fwillard/CANTranslate/Hardware/KiCad/CANTranslate/KMR223G LFG.STEP

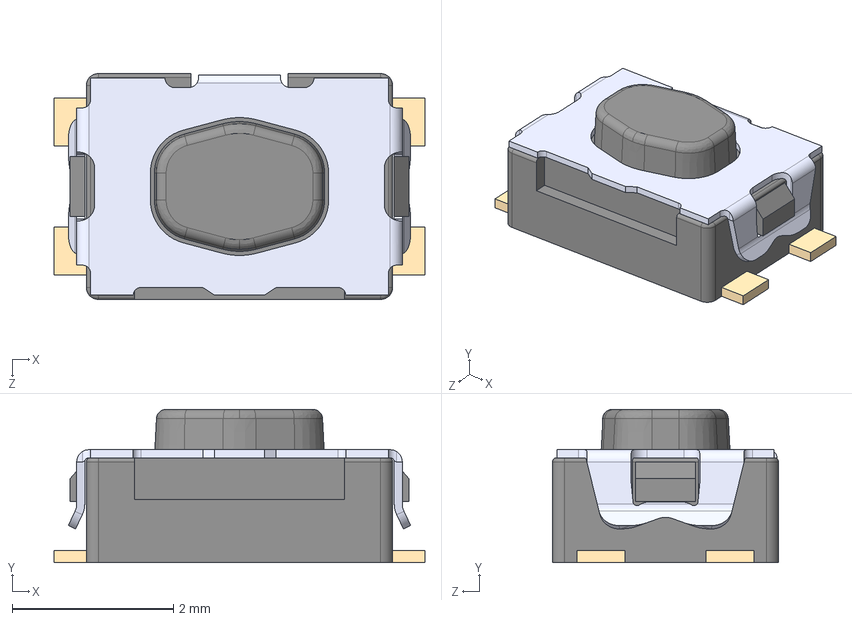
[picture p2: CAD file, 2025-05-18]
Hardware/KiCad/CANTranslate/KMR223G LFG.STEP
4.60 x 1.90 x 2.80 mm
