fwillard/CANTranslate/Hardware/KiCad/CANTranslate/Schematic/CANTranslate.pdf

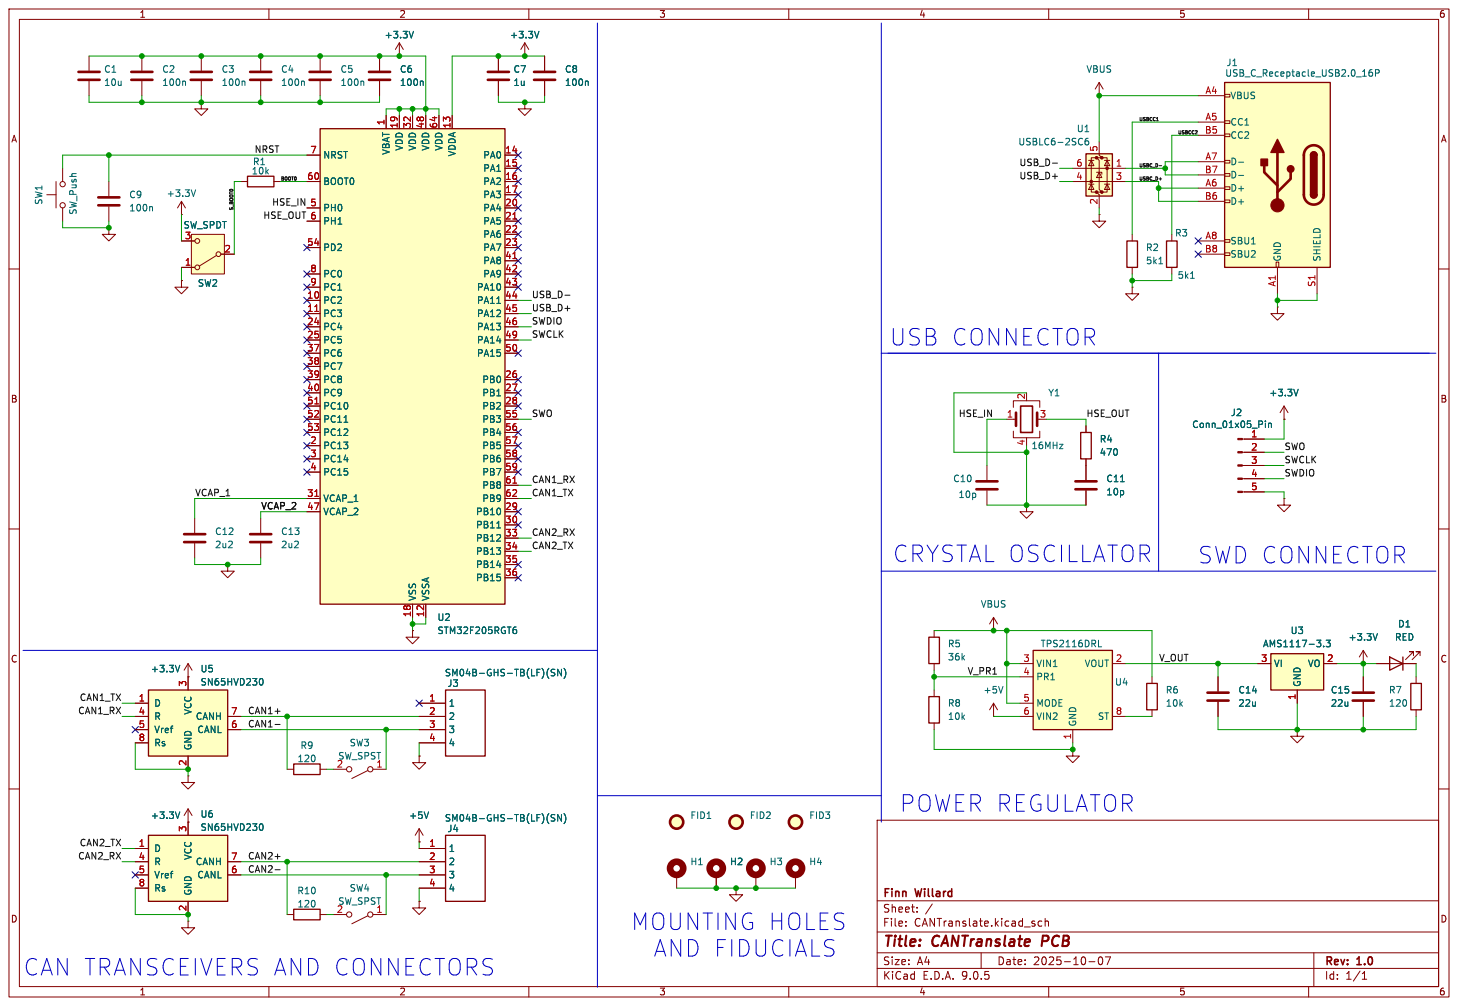
[picture p3: page 1]

1 VDD 19 VDD 32 VSS 18 VDD 48 VSSA 12 VDD 64 VDDA 13 PA0 14 PA1 15 PA2 16 PA3 17 PA4 20 PA5 21 PA6 22 PA7 23 PA8 41 PA9 42 PA10 43 PA11 44 PA12 45 PA13 46 PA14 49 PA15 50 PB0 26 PB1 27 PB2 28 PB3 55 PB4 56 PB5 57 PB6 58 PB7 59 PB8 61 PB9 62 PB10 29 PB11 30 PB12 33 PB13 34 PB14 35 PB15 36 SW2 SW_SPDT

1 VDD 19 VDD 32 VSS 18 VDD 48 VSSA 12 VDD 64 VDDA 13 PA0 14 PA1 15 PA2 16 PA3 17 PA4 20 PA5 21 PA6 22 PA7 23 PA8 41 PA9 42 PA10 43 PA11 44 PA12 45 PA13 46 PA14 49 PA15 50 PB0 26 PB1 27 PB2 28 PB3 55 PB4 56 PB5 57 PB6 58 PB7 59 PB8 61 PB9 62 PB10 29 PB11 30 PB12 33 PB13 34 PB14 35 PB15 36 U2STM32F205RGT6

J3 SM04B-GHS-TB(LF)(SN) 1

J4 SM04B-GHS-TB(LF)(SN) 1

File: CANTranslate.kicad_sch Sheet: / Finn Willard

CAN TRANSCEIVERS AND CONNECTORS

Id: 1/1 Title: CANTranslate PCB
