fwillard/CANTranslate/Hardware/KiCad/CANTranslate/CANTranslate.kicad_pcb

## KiCad design Hardware/KiCad/CANTranslate/CANTranslate.kicad_pcb (2025-10-28)

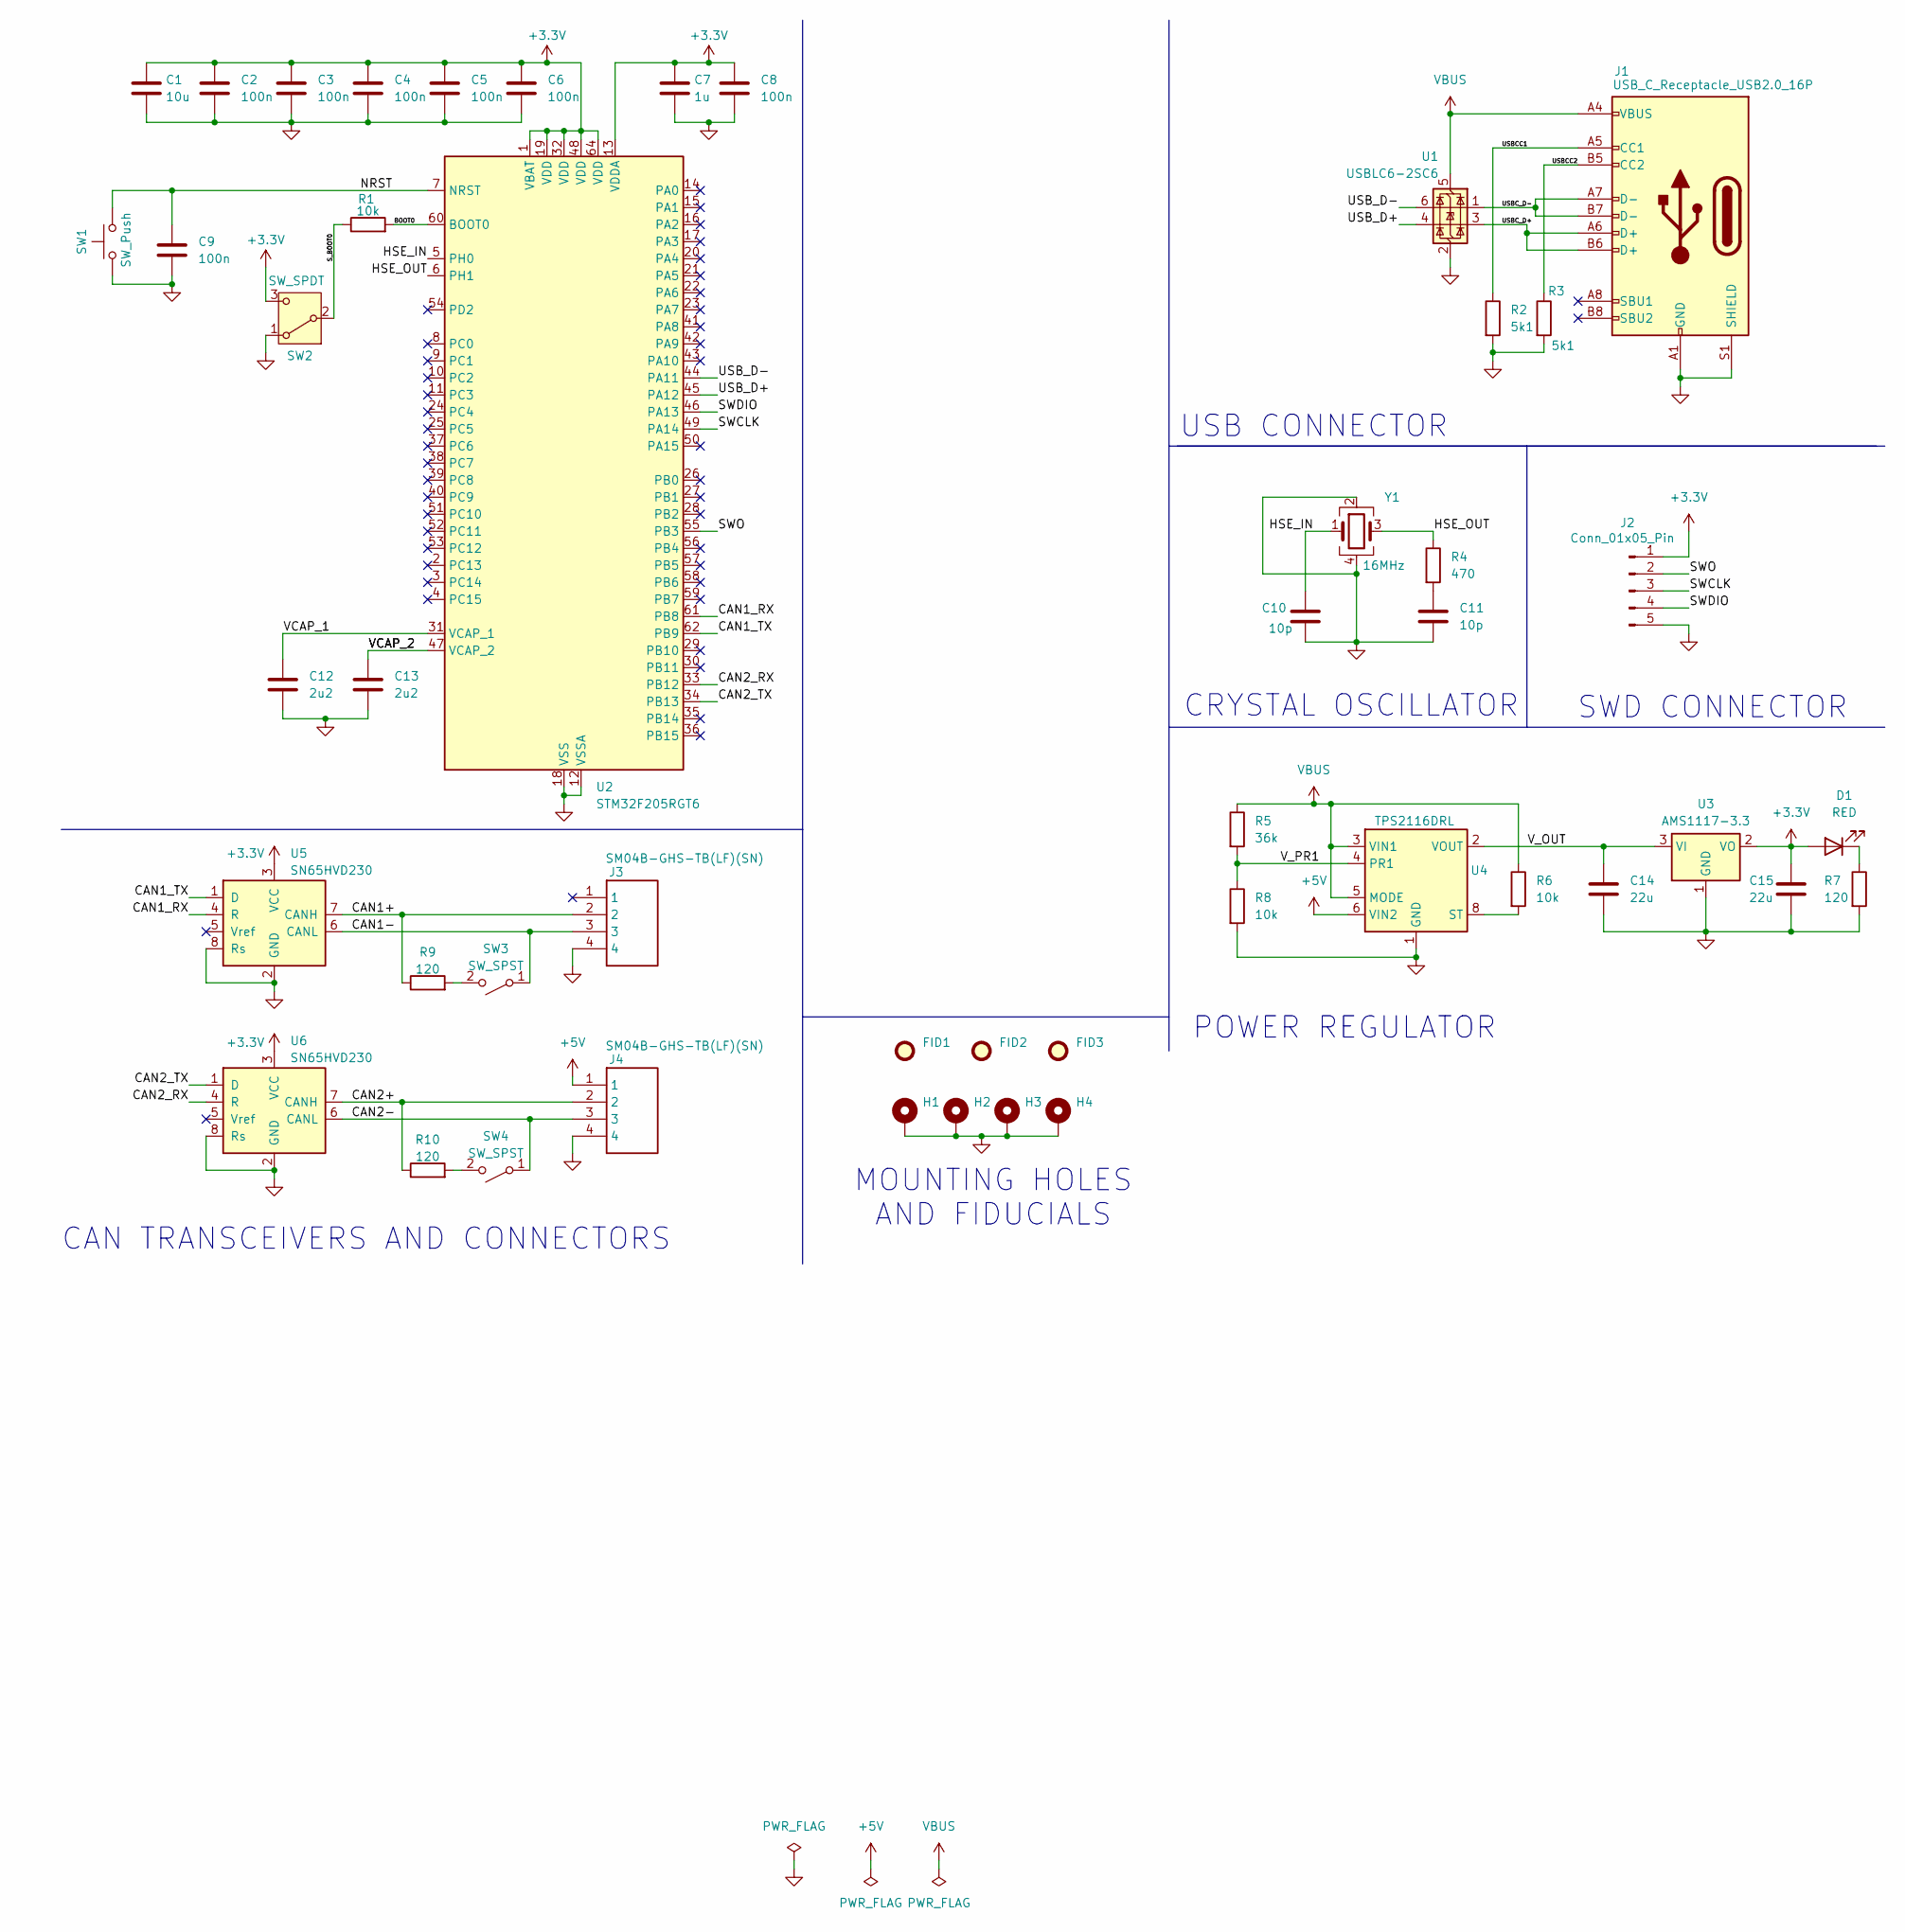
[picture p4: schematic CANTranslate.kicad_sch, CANTranslate PCB]

Parts:
C1: 10u; C_0603_1608Metric; LCSC C1691
C2, C3, C4, C5, C6, C8, C9: 100n; C_0402_1005Metric; LCSC C1525
C7: 1u; C_0603_1608Metric; LCSC C15849
C10, C11: 10p; C_0402_1005Metric; LCSC C32949
C12, C13: 2u2; C_0402_1005Metric; LCSC C12530
C14, C15: 22u; C_0805_2012Metric; LCSC C45783
D1: RED; LED_0603_1608Metric; LCSC C2286
FID1, FID2, FID3: Fiducial; Fiducial_1mm_Mask2mm
H1, H2, H3, H4: MountingHole_Pad; MountingHole_2.2mm_M2_Pad
J1: USB_C_Receptacle_USB2.0_16P; USB_C_Receptacle_GCT_USB4105-xx-A_16P_TopMnt_Horizontal; LCSC C393939
J2: Conn_01x05_Pin; PinHeader_1x05_P2.54mm_Horizontal; LCSC C5383098
J3, J4: SM04B-GHS-TB(LF)(SN); JST_GH_SM04B-GHS-TB_1x04-1MP_P1.25mm_Horizontal; Manufacturer Part SM04B-GHS-TB(LF)(SN); LCSC C189895
R1, R6, R8: 10k; R_0402_1005Metric; LCSC C25744
R2, R3: 5k1; R_0402_1005Metric; LCSC C25905
R4: 470; R_0402_1005Metric; LCSC C25117
R5: 36k; R_0402_1005Metric; LCSC C25556
R7, R9, R10: 120; R_0402_1005Metric; LCSC C25079
SW1: SW_Push; SW_Push_1P1T_NO_CK_KMR2; LCSC C221682
SW2: SW_SPDT; SW-TH_SS12D07VG4; LCSC C2939726
SW3, SW4: SW_SPST; SW-SMD_DSIC01LSGET; LCSC C54948
U1: USBLC6-2SC6; SOT-23-6; LCSC C2827654
U2: STM32F205RGT6; LQFP-64_10x10mm_P0.5mm; LCSC C30481
U3: AMS1117-3.3; SOT-223-3_TabPin2; LCSC C6186
U4: TPS2116DRL; SOT-583-8; LCSC C3235557
U5, U6: SN65HVD230; SOIC-8_3.9x4.9mm_P1.27mm; LCSC C12084
Y1: 16MHz; Crystal_SMD_3225-4Pin_3.2x2.5mm; LCSC C13738

Connections:
+3.3V: C1.1, C2.1, C3.1, C4.1, C5.1, C6.1, C7.1, C8.1, C15.1, D1.2 (A), J2.1, SW2.3 (C), U2.1 (VBAT), U2.13 (VDDA), U2.19 (VDD), U2.32 (VDD), U2.48 (VDD), U2.64 (VDD), U3.2 (VO), U5.3 (VCC), U6.3 (VCC)
+5V: J4.1, U4.6 (VIN2)
/BOOT0: R1.2, U2.60 (BOOT0)
/CAN1+: J3.2, R9.1, U5.7 (CANH)
/CAN1-: J3.3, SW3.1 (A), U5.6 (CANL)
/CAN1_RX: U2.61 (PB8), U5.4 (R)
/CAN1_TX: U2.62 (PB9), U5.1 (D)
/CAN2+: J4.2, R10.1, U6.7 (CANH)
/CAN2-: J4.3, SW4.1 (A), U6.6 (CANL)
/CAN2_RX: U2.33 (PB12), U6.4 (R)
/CAN2_TX: U2.34 (PB13), U6.1 (D)
/HSE_IN: C10.1, U2.5 (PH0), Y1.1
/HSE_OUT: R4.1, U2.6 (PH1), Y1.3
/NRST: C9.1, SW1.2, U2.7 (NRST)
/SWCLK: J2.3, U2.49 (PA14)
/SWDIO: J2.4, U2.46 (PA13)
/SWO: J2.2, U2.55 (PB3)
/S_BOOT0: R1.1, SW2.2 (B)
/USBCC1: J1.A5 (CC1), R2.1
/USBCC2: J1.B5 (CC2), R3.1
/USBC_D+: J1.A6 (D+), J1.B6 (D+), U1.3 (I/O2)
/USBC_D-: J1.A7 (D-), J1.B7 (D-), U1.1 (I/O1)
/USB_D+: U1.4 (I/O2), U2.45 (PA12)
/USB_D-: U1.6 (I/O1), U2.44 (PA11)
/VCAP_1: C12.1, U2.31 (VCAP_1)
/VCAP_2: C13.1, U2.47 (VCAP_2)
/V_OUT: C14.1, U3.3 (VI), U4.2 (VOUT), U4.7 (VOUT)
/V_PR1: R5.2, R8.1, U4.4 (PR1)
GND: C1.2, C2.2, C3.2, C4.2, C5.2, C6.2, C7.2, C8.2, C9.2, C10.2, C11.2, C12.2, C13.2, C14.2, C15.2, H1.1, H2.1, H3.1, H4.1, J1.A1 (GND), J1.A12 (GND), J1.B1 (GND), J1.B12 (GND), J1.S1 (SHIELD), J2.5, J3.4, J4.4, R2.2, R3.2, R7.2, R8.2, SW1.1, SW2.1 (A), U1.2 (GND), U2.12 (VSSA), U2.18 (VSS), U2.63 (VSS), U3.1 (GND), U4.1 (GND), U5.2 (GND), U5.8 (Rs), U6.2 (GND), U6.8 (Rs), Y1.2, Y1.4
unnamed: C11.1, R4.2
unnamed: D1.1 (K), R7.1
unnamed: R9.2, SW3.2 (B)
unnamed: R10.2, SW4.2 (B)
unnamed: R6.2, U4.8 (ST)
VBUS: J1.A4 (VBUS), J1.A9 (VBUS), J1.B4 (VBUS), J1.B9 (VBUS), R5.1, R6.1, U1.5 (VBUS), U4.3 (VIN1), U4.5 (MODE)

Notes on the sheet:
CRYSTAL OSCILLATOR
SWD CONNECTOR
USB CONNECTOR
CAN TRANSCEIVERS AND CONNECTORS
POWER REGULATOR
MOUNTING HOLES AND FIDUCIALS

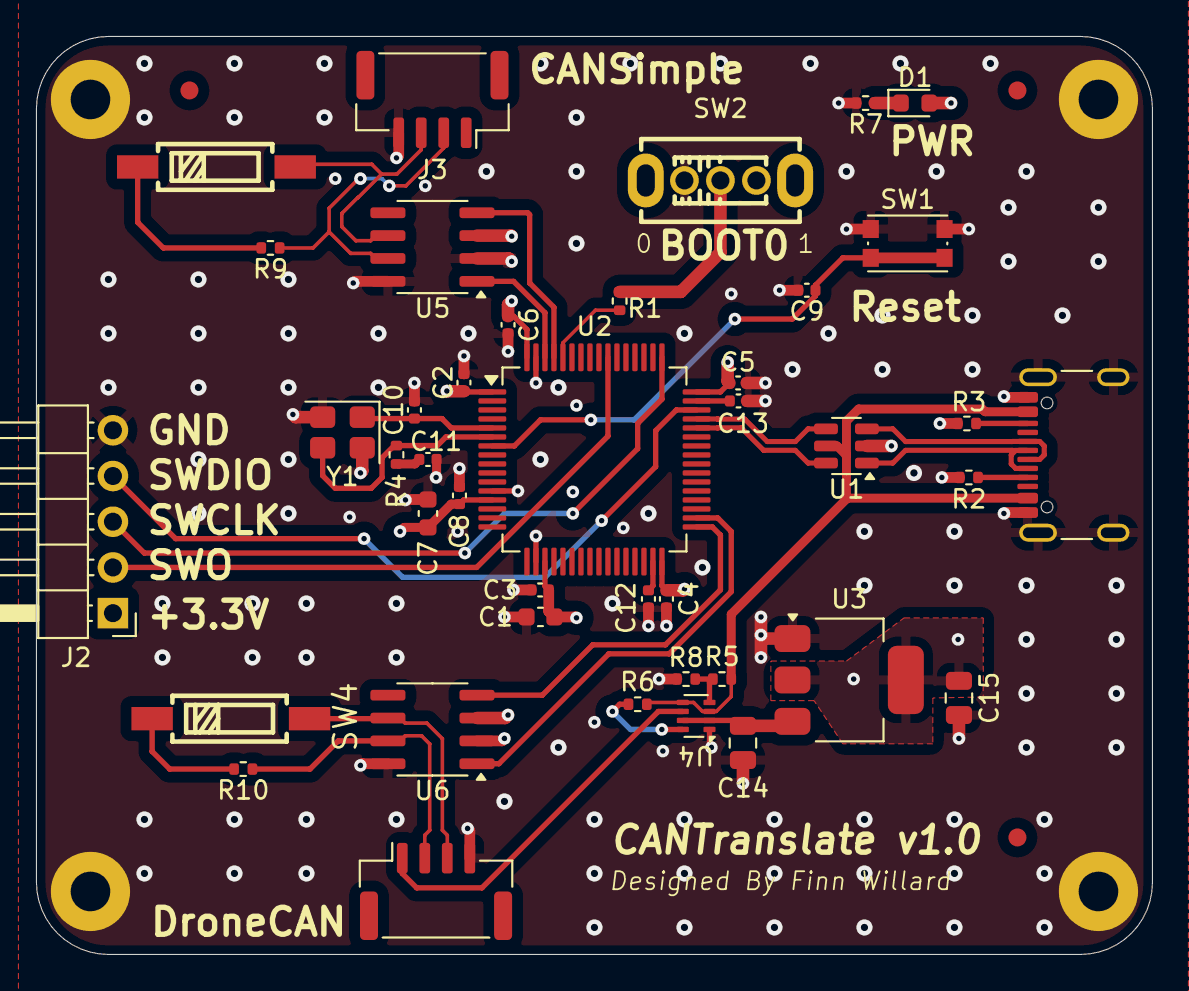
[picture p5: board CANTranslate.kicad_pcb from above]

Board: 4 copper layers, 62.0 x 51.0 mm, 48 parts (0 on the bottom side), 35 nets.
