fwillard/CANTranslate/CANTranslate.ioc

Mcu.UserName=STM32F103C8Tx
PA13.Signal=SYS_JTMS-SWDIO
PA14.Signal=SYS_JTCK-SWCLK
PB3.Signal=SYS_JTDO-TRACESWO
PB8.Signal=CAN_RX
PB9.Signal=CAN_TX
PD0-OSC_IN.Signal=RCC_OSC_IN
PD1-OSC_OUT.Signal=RCC_OSC_OUT
