fwillard/CANTranslate/(commit log)

2025-05-18 KiCad First Rev
    [CANTranslate.kicad_pcb, CANTranslate.kicad_sch, KMR223G LFG.STEP]
2025-05-27 Switch project over from C6 to C8 MCU
2025-05-30 Updated MCU from STM32F103C8T6 to STM32F303CCT6
    [CANTranslate.kicad_pcb, CANTranslate.kicad_sch]
2025-06-02 Fixed receive and put CAN in normal mode
    [CANTranslate.ioc, can.c]
2025-06-02 switch can transmit to single mailbox to ensure proper ordering of frames
2025-06-15 ESC testing
2025-06-18 initial odrive configs
2025-10-07 updated schematic to use two seprate CAN networks and different STM
    [CANTranslate.kicad_sch]
2025-10-28 More Hardware Updates
    [CANTranslate.kicad_pcb, CANTranslate.kicad_sch]
2025-10-28 git shenanigans
    [CANTranslate.kicad_pcb, CANTranslate.kicad_sch]
2025-10-29 Readme updates to reflect board changes
